pozsarzs/mm1a/pictures/mm1a-2.jpg

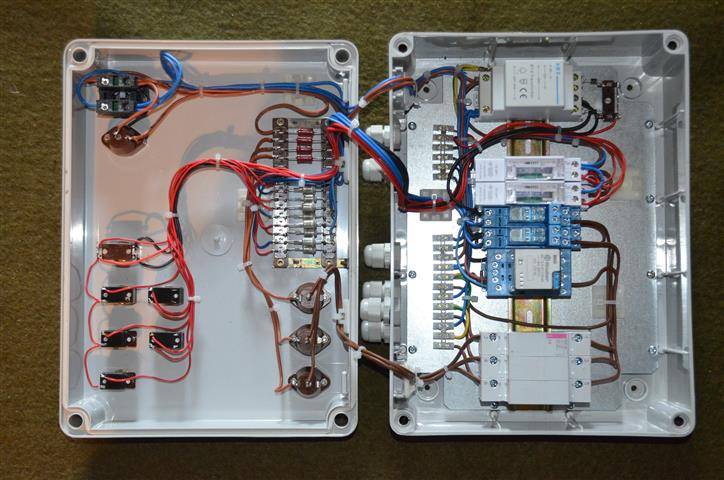
pictures/mm1a-2.jpg
