pozsarzs/mm1a/pictures/mm1a-1.jpg

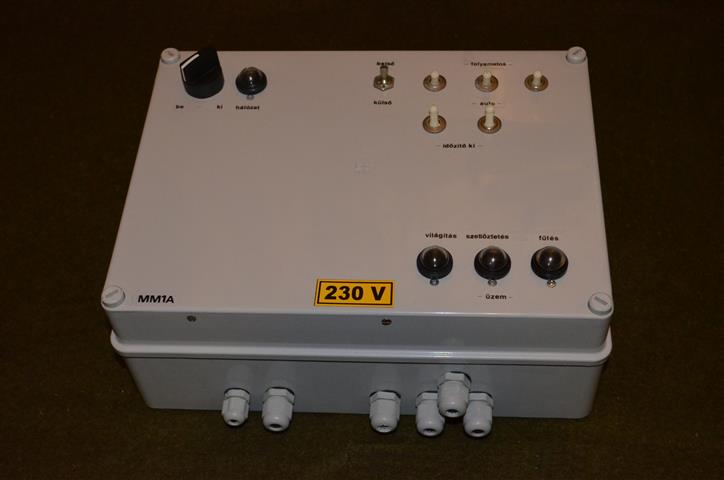
pictures/mm1a-1.jpg
