pozsarzs/mm1a/documents/sch_mm1a.pdf

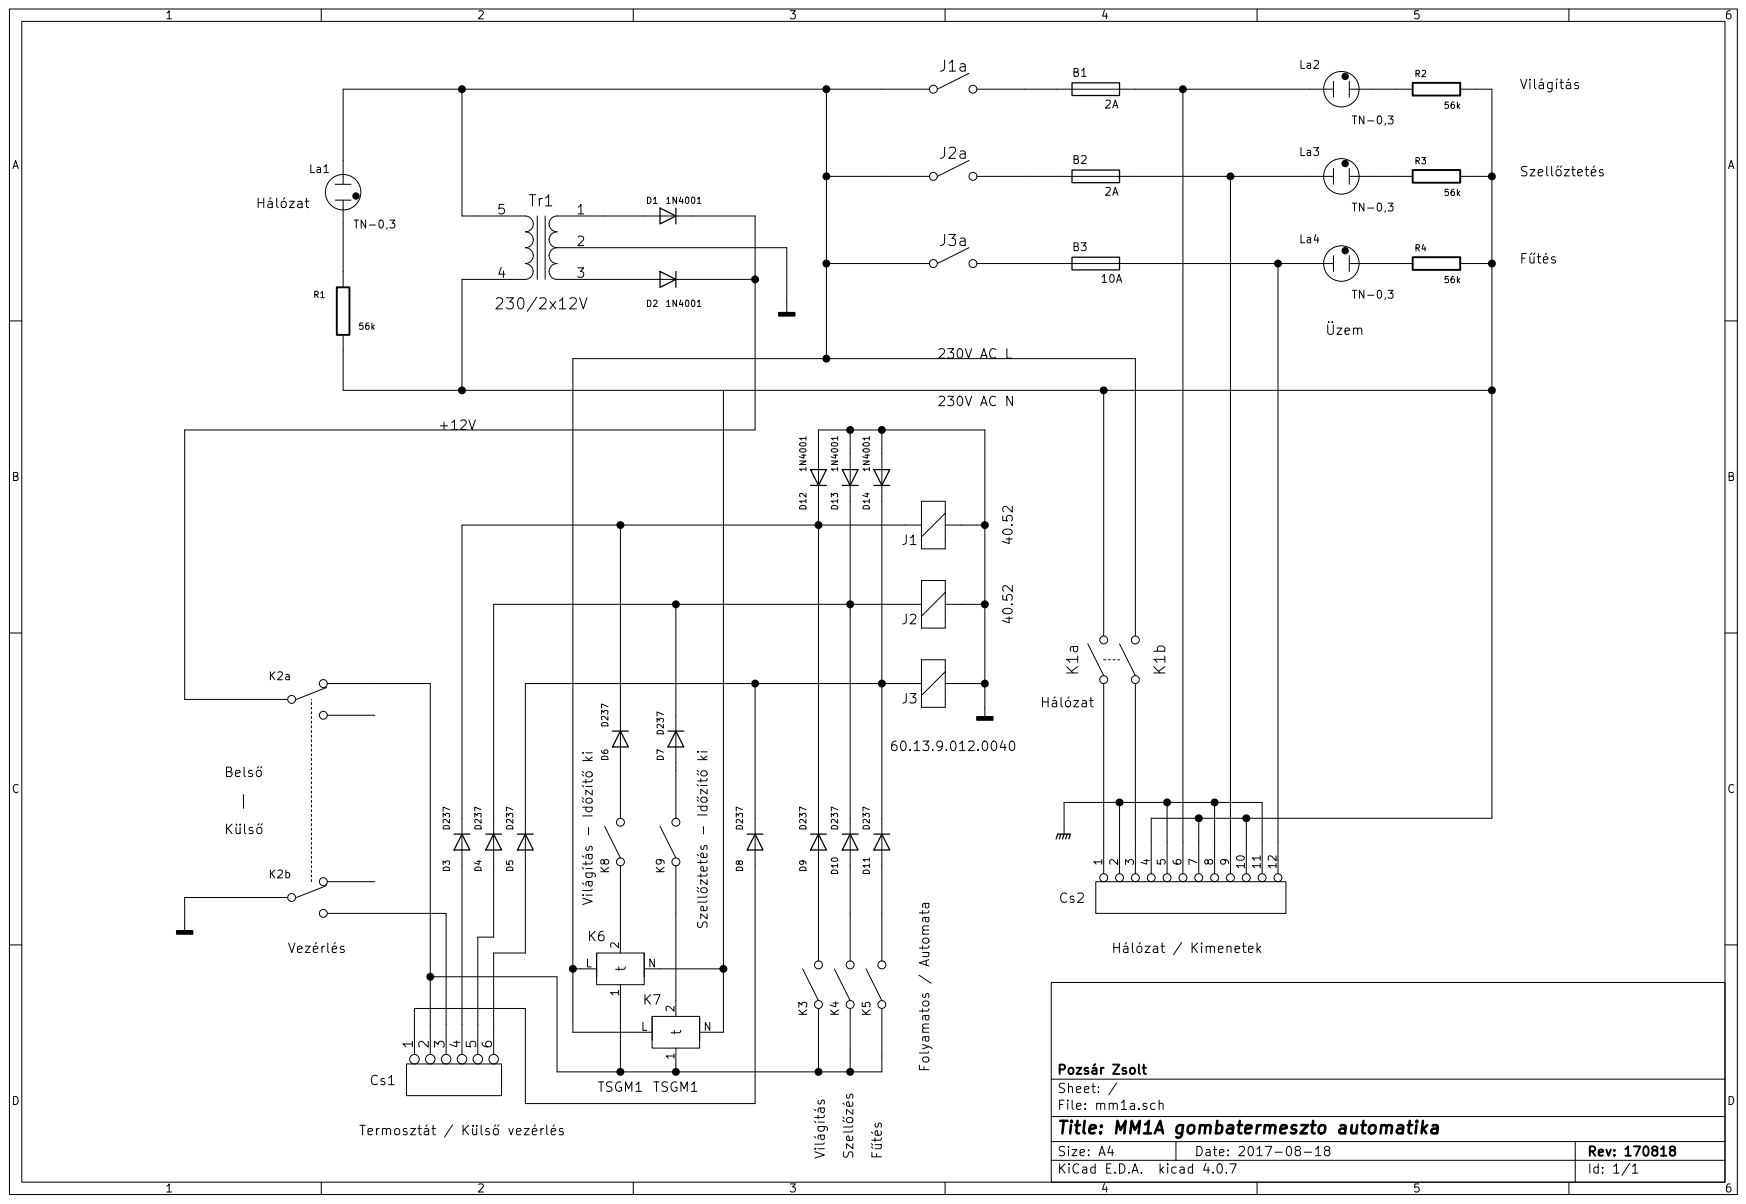
[picture p8: page 1]
