pozsarzs/mm1a/cad_files/mm1a.sch

## KiCad design cad_files/mm1a.sch (2018-12-23)

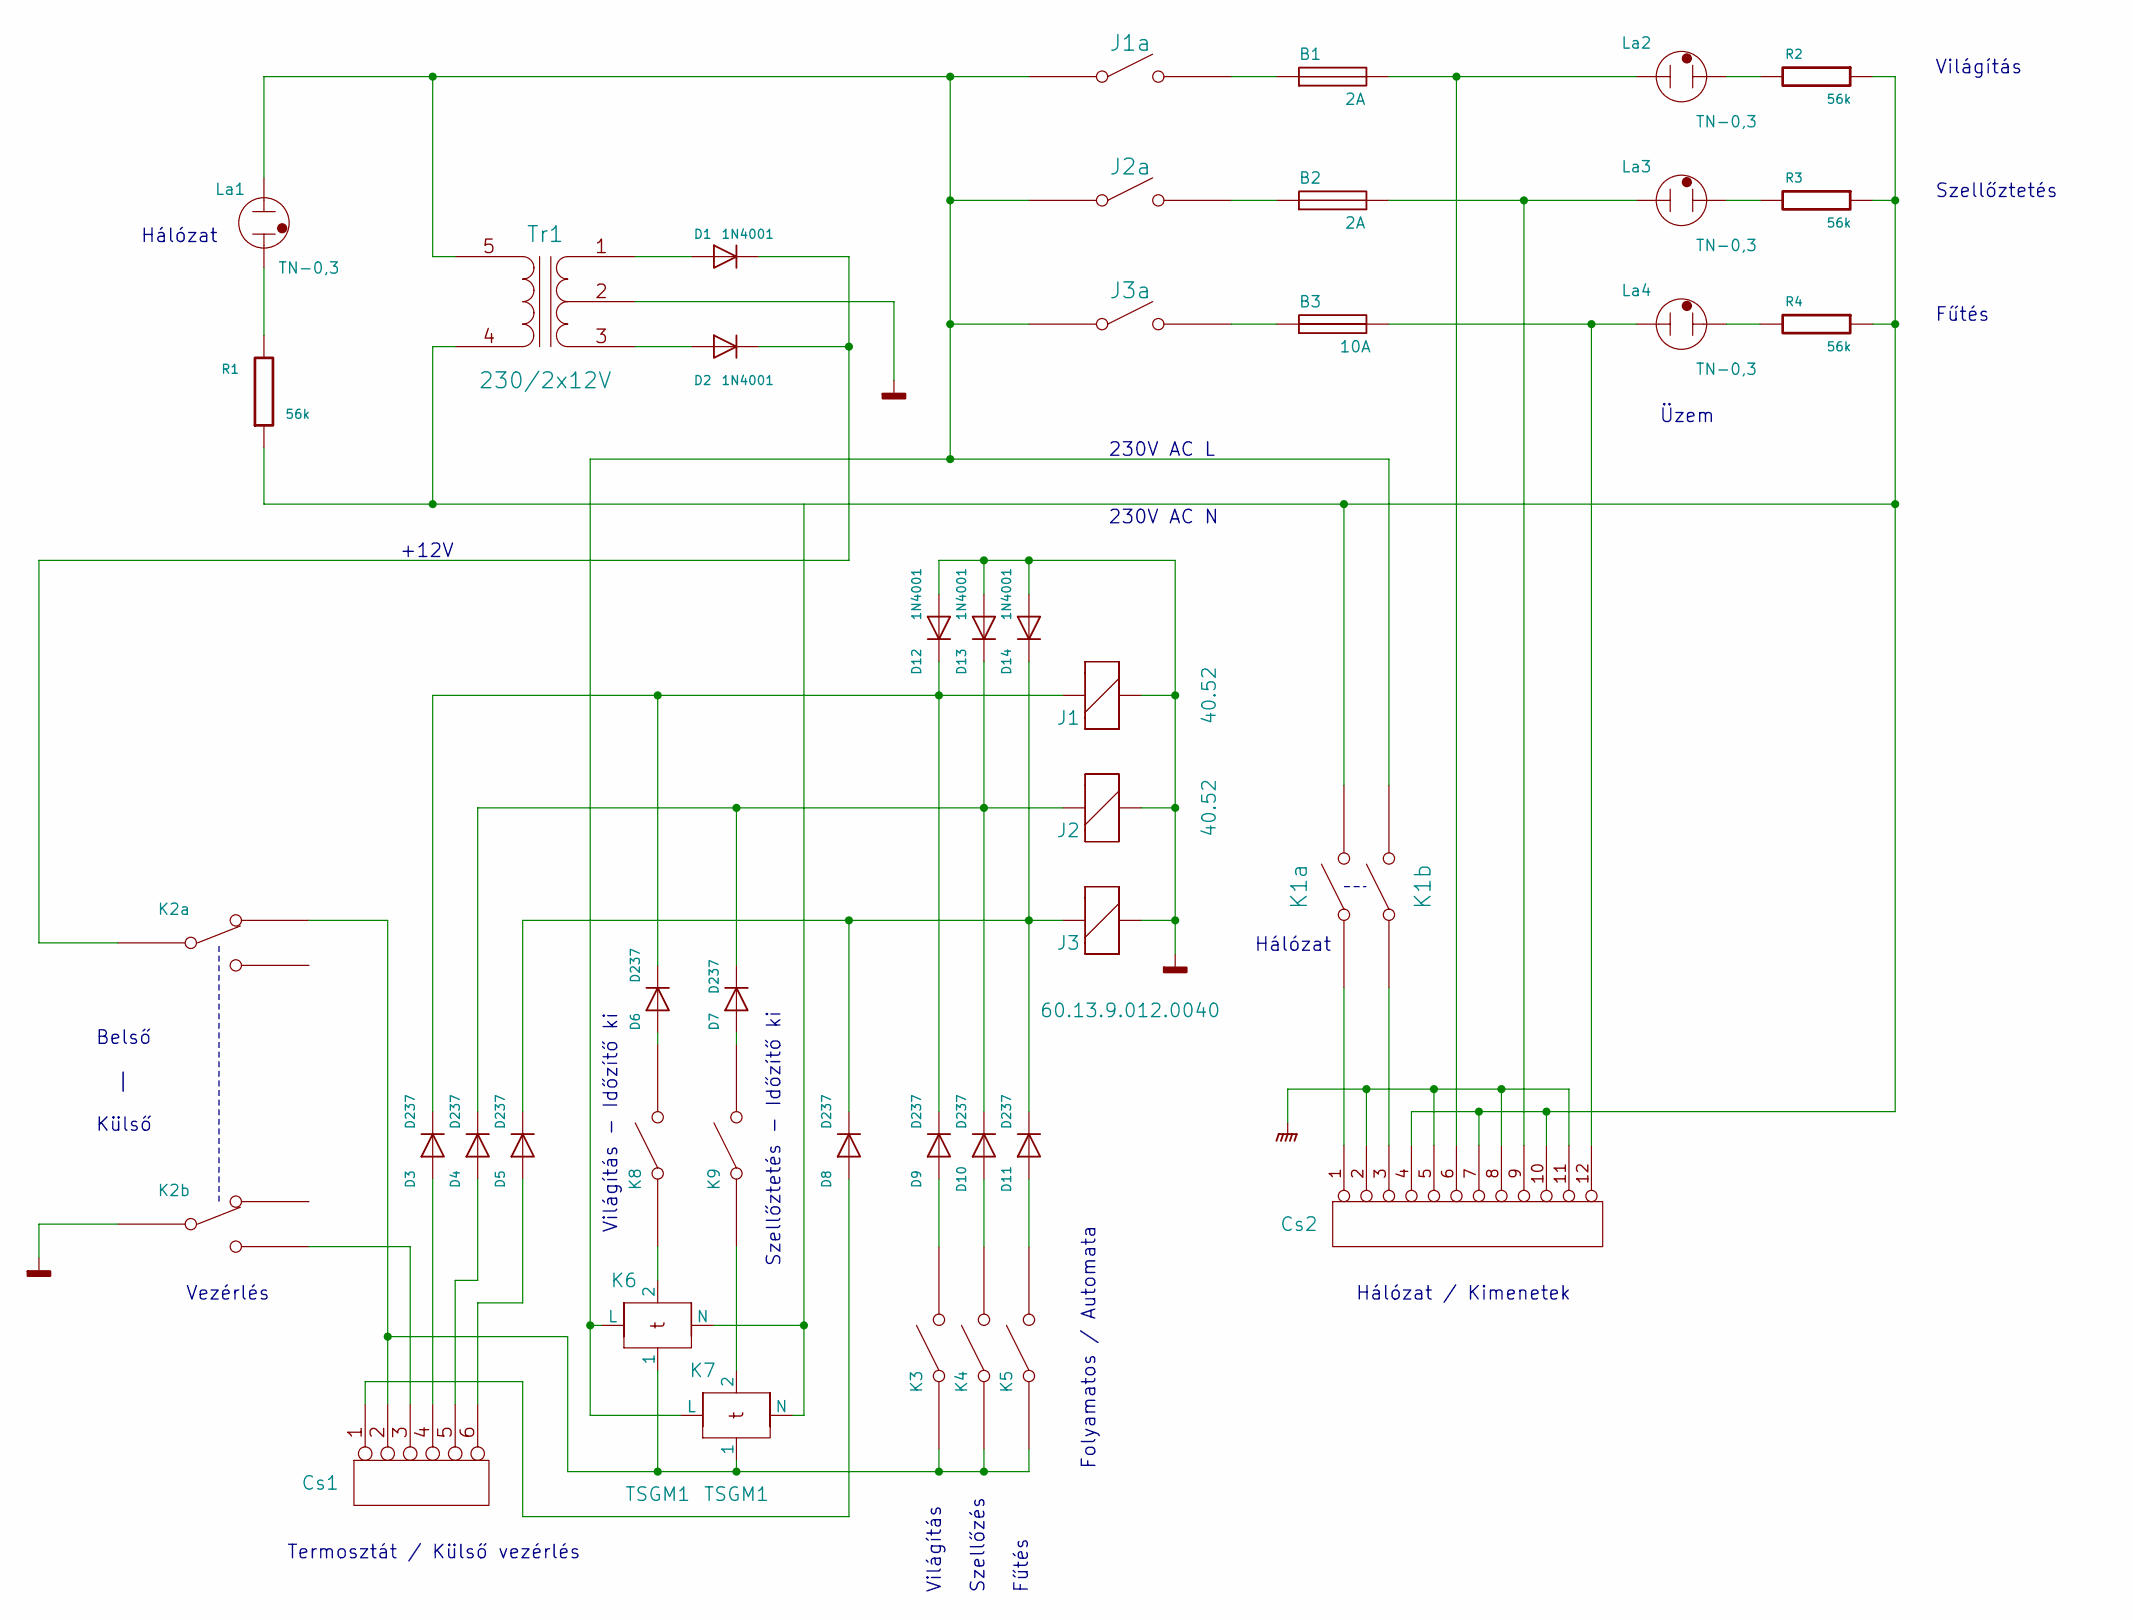
[picture p9: schematic mm1a.sch]

Parts:
B1, B2: 2A
B3: 10A
Cs1: CONN_6
Cs2: CONN_12
D1, D2, D12, D13, D14: 1N4001
D3, D4, D5, D6, D7, D8, D9, D10, D11: D237
J1, J2: 40.52
J1a, J2a, J3a: SPST
J3: 60.13.9.012.0040
K1a, K1b, K3, K4, K5, K8, K9: SPST
K2a, K2b: SWITCH_INV
K6, K7: TSGM1
La1, La2, La3, La4: TN-0,3; glimm
R1, R2, R3, R4: 56k
Tr1: 230/2x12V

Connections:
GNDD: D12.2 (A), D13.2 (A), D14.2 (A), J1.1, J2.1, J3.1, K2b.~, Tr1.2 (PM)
GNDPWR: Cs2.2, Cs2.5, Cs2.8, Cs2.11
unnamed: B1.1, J1a.2
unnamed: B1.2, Cs2.6, La2.1
unnamed: B2.1, J2a.2
unnamed: B2.2, Cs2.9, La3.1
unnamed: B3.1, J3a.2
unnamed: B3.2, Cs2.12, La4.1
unnamed: Cs1.1, D8.2 (A)
unnamed: Cs1.2, K2a.~, K3.1, K4.1, K5.1, K6.1, K7.1
unnamed: Cs1.3, K2b.~
unnamed: Cs1.4, D3.2 (A)
unnamed: Cs1.5, D4.2 (A)
unnamed: Cs1.6, D5.2 (A)
unnamed: Cs2.1, K1a.1
unnamed: Cs2.3, K1b.1
unnamed: Cs2.4, Cs2.7, Cs2.10, K1a.2, R1.1, R2.1, R3.1, R4.1, Tr1.4 (S1)
unnamed: D1.1 (K), D2.1 (K), K2a.~
unnamed: D1.2 (A), Tr1.1 (PR1)
unnamed: D2.2 (A), Tr1.3 (PR2)
unnamed: D6.2 (A), K8.2
unnamed: D7.2 (A), K9.2
unnamed: D9.2 (A), K3.2
unnamed: D4.1 (K), D7.1 (K), D10.1 (K), D13.1 (K), J2.2
unnamed: D10.2 (A), K4.2
unnamed: D5.1 (K), D8.1 (K), D11.1 (K), D14.1 (K), J3.2
unnamed: D11.2 (A), K5.2
unnamed: D3.1 (K), D6.1 (K), D9.1 (K), D12.1 (K), J1.2
unnamed: J1a.1, J2a.1, J3a.1, K1b.2, K6.L, K7.L, La1.1, Tr1.5 (S2)
unnamed: K6.2, K8.1
unnamed: K6.N, K7.N
unnamed: K7.2, K9.1
unnamed: La1.2, R1.2
unnamed: La2.2, R2.2
unnamed: La3.2, R3.2
unnamed: La4.2, R4.2

Notes on the sheet:
Hálózat
Világítás
Szellőztetés
Fűtés
Üzem
Termosztát / Külső vezérlés
Hálózat / Kimenetek
Vezérlés
Folyamatos / Automata
Világítás Szellőzés Fűtés
+12V
230V AC L
230V AC N
Belső | Külső
Szellőztetés - Időzítő ki
Világítás - Időzítő ki
